Raphael-Tibbits/ClockV2/V2_1/ClockV2_1/ClockV2_1.csv

Reference | Qty | Value | DNP | Exclude from BOM | Exclude from Board | Footprint | Datasheet
BT1,BT2 | 2 | 2.4V 2s NiMH |  |  |  | Battery:BatteryHolder_Keystone_2468_2xAAA | ~
C1,C7,C11,C12,C13,C207 | 6 | 1u |  |  |  | Capacitor_SMD:C_0805_2012Metric | ~
C2 | 1 | 2.2u |  |  |  | Capacitor_SMD:C_0805_2012Metric | ~
C3,C201,C208 | 3 | 10n |  |  |  | Capacitor_SMD:C_0603_1608Metric | ~
C4 | 1 | 100n |  |  |  | Capacitor_SMD:C_0805_2012Metric | ~
C5,C6,C10 | 3 | 22u |  |  |  | Capacitor_SMD:C_1206_3216Metric | ~
C8 | 1 | 220n |  |  |  | Capacitor_SMD:C_0805_2012Metric | ~
C9 | 1 | 10u |  |  |  | Capacitor_SMD:C_1206_3216Metric | ~
C105 | 1 | 15p |  |  |  | Capacitor_SMD:C_0603_1608Metric | ~
C107,C109,C203 | 3 | 150p |  |  |  | Capacitor_SMD:C_0603_1608Metric | ~
C202 | 1 | 0.1-2p |  |  |  | Capacitor_SMD:C_Trimmer_Voltronics_JZ | ~
C204 | 1 | 3-30p |  |  |  | Capacitor_SMD:C_Trimmer_Voltronics_JZ | ~
C205 | 1 | 22p C0G |  |  |  | Capacitor_SMD:C_0805_2012Metric | ~
D1,D2,D4,D5 | 4 | B320 |  |  |  | Diode_SMD:D_SMC | http://www.jameco.com/Jameco/Products/ProdDS/1538777.pdf
D3 | 1 | 1.5SMCxxCA |  |  |  | Diode_SMD:D_SMC | https://www.vishay.com/docs/88303/15smc.pdf
D201 | 1 | 1N4148WS |  |  |  | Diode_SMD:D_SOD-323 | https://www.vishay.com/docs/85751/1n4148ws.pdf
D301,D302 | 2 | RED |  |  |  | LED_SMD:LED_0805_2012Metric | ~
D304 | 1 | GRN |  |  |  | LED_SMD:LED_0805_2012Metric | ~
DS401 | 1 | LTD-4608JR |  |  |  | LTD_4608JR:LTD-4608JR_LTO | LTD-4608JR
DS402 | 1 | TDCR1060M |  |  |  | TDCR1060M:DISPLAY_TDCR1060M
FB1 | 1 | FerriteBead |  |  |  | Inductor_SMD:L_1806_4516Metric | ~
H101,H102,H103,H104 | 4 | MountingHole_Pad |  |  |  | MountingHole:MountingHole_3.2mm_M3_DIN965_Pad | ~
J101 | 1 | Conn_Coaxial |  |  |  | Connector_Coaxial:SMA_Amphenol_132289_EdgeMount | ~
J103,J104,J201,J202 | 4 | Conn_02x04_Odd_Even |  |  |  | Connector_PinSocket_2.54mm:PinSocket_2x04_P2.54mm_Vertical | ~
J105 | 1 | DIN41612_02x16_AC_EvenPins |  |  |  | Connector_DIN:DIN41612_C_2x16_Male_Horizontal_THT | ~
J302 | 1 | Conn_02x04_Odd_Even |  |  |  | Connector_PinHeader_2.54mm:PinHeader_2x04_P2.54mm_Horizontal | ~
J303 | 1 | Conn_02x06_Odd_Even |  |  |  | Connector_PinHeader_2.54mm:PinHeader_2x06_P2.54mm_Horizontal | ~
j304 | 1 | Conn_01x04 |  |  |  | Connector_PinHeader_2.54mm:PinHeader_1x04_P2.54mm_Horizontal | ~
J401 | 1 | Conn_01x04 |  |  |  | Connector_PinHeader_2.54mm:PinHeader_1x04_P2.54mm_Vertical | ~
J402 | 1 | Conn_02x04_Odd_Even |  |  |  | Connector_PinHeader_2.54mm:PinHeader_2x04_P2.54mm_Vertical_SMD | ~
J403 | 1 | Conn_02x06_Odd_Even |  |  |  | Connector_PinHeader_2.54mm:PinHeader_2x06_P2.54mm_Vertical_SMD | ~
JP1,JP2,JP3,JP4,JP5,JP6,JP7,JP8,JP9 | 9 | SolderJumper_2_Open |  | Excluded from BOM |  | Jumper:SolderJumper-2_P1.3mm_Open_RoundedPad1.0x1.5mm | ~
L1 | 1 | 1.5u |  |  |  | Inductor_SMD:L_Bourns-SRU1028_10.0x10.0mm | ~
L101 | 1 | 8.4u 2% |  |  |  | Inductor_SMD:L_0603_1608Metric | ~
L102 | 1 | 620n 2% |  |  |  | Inductor_SMD:L_1008_2520Metric | ~
Q201 | 1 | IRLR024N |  |  |  | PCM_Package_TO_SOT_SMD_AKL:TO-252-2 | https://www.tme.eu/Document/adabf59c12041ebc2d466e35a3111f05/irlr024npbf.pdf
R1 | 1 | 22k |  |  |  | Resistor_SMD:R_0805_2012Metric | ~
R2 | 1 | 22R |  |  |  | Resistor_SMD:R_1206_3216Metric | ~
R3 | 1 | 107k |  |  |  | Resistor_SMD:R_0805_2012Metric | ~
R4 | 1 | 24.9k |  |  |  | Resistor_SMD:R_0805_2012Metric | ~
R5,R208 | 2 | 100k |  |  |  | Resistor_SMD:R_0805_2012Metric | ~
R107,R202,R203,R207,R311,R312 | 6 | 1k |  |  |  | Resistor_SMD:R_0805_2012Metric | ~
R111,R313,R314,R315 | 4 | 330R |  |  |  | Resistor_SMD:R_0805_2012Metric | ~
R201,R209,R210 | 3 | 47k |  |  |  | Resistor_SMD:R_0805_2012Metric | ~
R204 | 1 | 5M |  |  |  | Resistor_SMD:R_0805_2012Metric | ~
R205 | 1 | 470R |  |  |  | Resistor_SMD:R_0805_2012Metric | ~
R206 | 1 | 0.02R |  |  |  | Resistor_SMD:R_2512_6332Metric | ~
R301,R302,R303,R304,R305,R306,R307,R308,R310,R317,R318 | 11 | 150 |  |  |  | Resistor_SMD:R_0805_2012Metric | ~
R309 | 1 | LDR03 |  |  |  | OptoDevice:R_LDR_5.1x4.3mm_P3.4mm_Vertical | http://www.elektronica-componenten.nl/WebRoot/StoreNL/Shops/61422969/54F1/BA0C/C664/31B9/2173/C0A8/2AB9/2AEF/LDR03IMP.pdf
RV201 | 1 | 10k |  |  |  | Potentiometer_THT:Potentiometer_Bourns_3266W_Vertical | ~
SW301 | 1 | SW_Push |  |  |  | Button_Switch_THT:SW_PUSH_6mm_H4.3mm | ~
TH201 | 1 | Thermistor_NTC |  |  |  | Resistor_SMD:R_0805_2012Metric | ~
TP1,TP2 | 2 | TestPoint |  |  |  |  | ~
U1 | 1 | NUCLEO-L432KC |  | Excluded from BOM |  | ClockV2_1:MODULE_NUCLEO-L432KC
U2 | 1 | LMR33630CDDA |  |  |  | Package_SO:HTSOP-8-1EP_3.9x4.9mm_P1.27mm_EP2.4x3.2mm_ThermalVias | http://www.ti.com/lit/ds/symlink/lmr33630.pdf
U3 | 1 | LP2985-33DBVR |  |  |  | Package_TO_SOT_SMD:SOT-23-5 | http://www.ti.com/general/docs/suppproductinfo.tsp?distId=10
U201 | 1 | 74LVC1GX04 |  |  |  | Package_TO_SOT_SMD:SOT-23-6_Handsoldering
U202 | 1 | LMV358 |  |  |  | Package_SO:SOIC-8_3.9x4.9mm_P1.27mm | http://www.ti.com/lit/ds/symlink/lmv324.pdf
U301,U302,U303 | 3 | 74HC595 |  |  |  | Package_SO:SOIC-16_3.9x9.9mm_P1.27mm | http://www.ti.com/lit/ds/symlink/sn74hc595.pdf
Y201 | 1 | 16MHz |  |  |  | Crystal:Crystal_SMD_HC49-SD | ~
