Raphael-Tibbits/ClockV2/V2_1/ClockV2_1/ClockV2_1.step

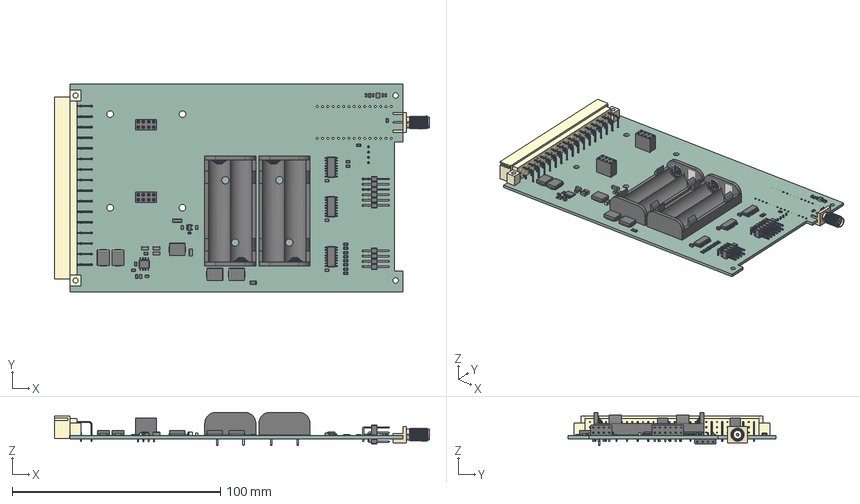
[picture p1: CAD file, 2026-08-30]
V2_1/ClockV2_1/ClockV2_1.step
180.2 x 100.0 x 16.0 mm
C_1206_3216Metric x 4
BatteryHolder_Keystone_2468_2xAAA x 2
R_0805_2012Metric x 16
D_SMC x 5
C_0805_2012Metric x 8
SOIC-16_3.9x9.9mm_P1.27mm x 3
PinSocket_2x04_P2.54mm_Vertical x 2
L_1806_4516Metric
HTSOP-8-1EP_3.9x4.9mm_P1.27mm_EP2.4x3.2mm
R_1206_3216Metric
L_0603_1608Metric
C_0603_1608Metric x 4
DIN41612_C_2x16_Male_Horizontal_THT
PinHeader_2x04_P2.54mm_Horizontal
L_1008_2520Metric
PinHeader_2x06_P2.54mm_Horizontal
SOT-23-5
SMA_Amphenol_132289_EdgeMount
PinHeader_1x04_P2.54mm_Horizontal
ClockV2_1_PCB
