Raphael-Tibbits/ClockV2/V2_1/Mechanical/ClockV2_osc.step

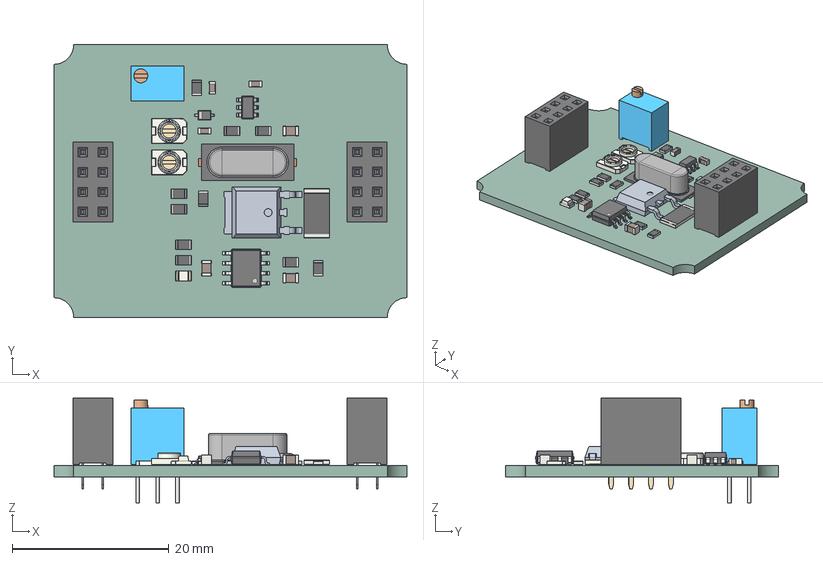
[picture p2: CAD file, 2026-08-30]
V2_1/Mechanical/ClockV2_osc.step
45.0 x 34.8 x 13.4 mm
R_0805_2012Metric x 10
Crystal_SMD_HC49-SD
ClockV2_osc 1.4.1
SOT-23-6
PinSocket_2x04_P2.54mm_Vertical x 2
C_0603_1608Metric x 3
C_Trimmer_Voltronics_JZ x 2
D_SOD-323
LED_0805_2012Metric
C_0805_2012Metric x 3
SOIC-8_3.9x4.9mm_P1.27mm
R_2512_6332Metric
Potentiometer_Bourns_3266W_Vertical
ClockV2_osc_PCB
