Raphael-Tibbits/ClockV2/V2_1/Mechanical/ClockV2_fp.step

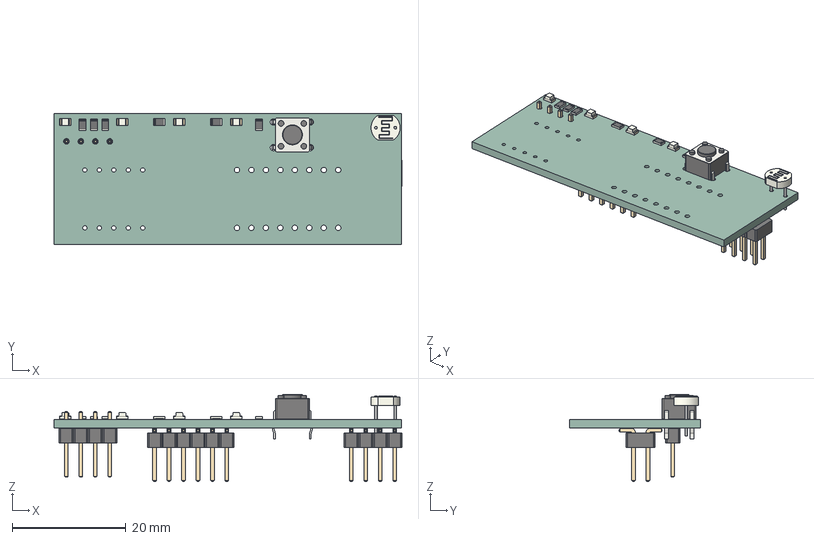
[picture p3: CAD file, 2026-08-30]
V2_1/Mechanical/ClockV2_fp.step
61.1 x 23.0 x 15.3 mm
LED_0805_2012Metric x 4
R_0805_2012Metric x 6
R_LDR_5.1x4.3mm_P3.4mm_Vertical
SW_PUSH_6mm_H4.3mm
PinHeader_2x06_P2.54mm_Vertical_SMD
PinHeader_2x04_P2.54mm_Vertical_SMD
PinHeader_1x04_P2.54mm_Vertical
ClockV2_fp_PCB
