Raphael-Tibbits/ClockV2/V2_1/Mechanical/ClockV2.step

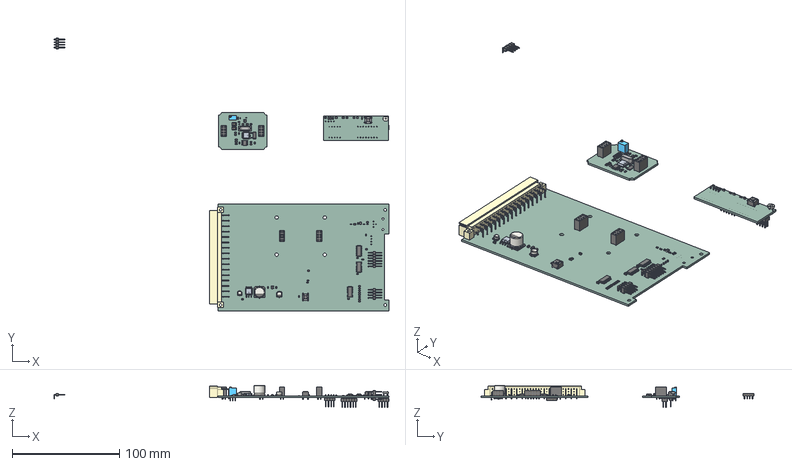
[picture p4: CAD file, 2026-08-30, an earlier design]
V2_1/Mechanical/ClockV2.step
313.0 x 254.9 x 21.0 mm
R_0805_2012Metric x 30
DIN41612_C_2x16_Male_Horizontal_THT
SW_PUSH_6mm_H4.3mm x 2
LED_0805_2012Metric x 5
Crystal_SMD_HC49-SD
ClockV2 1.8.1
C_0805_2012Metric x 11
PinHeader_2x04_P2.54mm_Horizontal
SOT-23-6
C_0603_1608Metric x 7
PinSocket_2x04_P2.54mm_Vertical x 4
L_1008_2520Metric
C_Trimmer_Voltronics_JZ x 2
SOIC-16_3.9x9.9mm_P1.27mm x 3
D_SOD-323
R_LDR_5.1x4.3mm_P3.4mm_Vertical
SOT-23-5
PinHeader_1x04_P2.54mm_Horizontal x 2
SOIC-8_3.9x4.9mm_P1.27mm
CP_Elec_5x3.9
CP_Elec_4x3
L_0603_1608Metric
ClockV2 1.68.1
R_2512_6332Metric
PinHeader_2x06_P2.54mm_Horizontal
CP_Elec_10x10
Potentiometer_Bourns_3266W_Vertical
PinHeader_2x06_P2.54mm_Vertical_SMD
PinHeader_2x04_P2.54mm_Vertical_SMD
PinHeader_1x04_P2.54mm_Vertical
ClockV2_PCB_1
ClockV2_PCB_2
ClockV2_PCB_3
