Raphael-Tibbits/ClockV2/(list of files, cad)

Other CAD files:
V2_1/Mechanical/ClockV2_1.step
V2_0/ClockV2.step
