Raphael-Tibbits/ClockV2/Manufacturing/Gerbers/Panel/Panel_Combined_Bottom.png

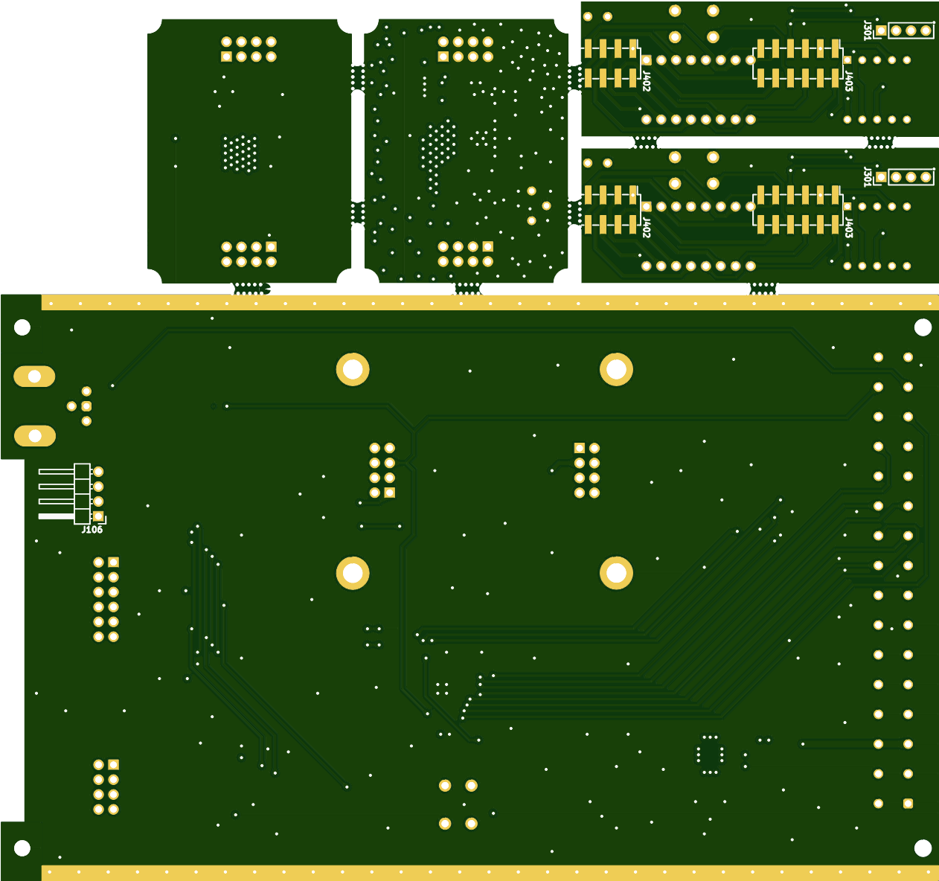
Manufacturing/Gerbers/Panel/Panel_Combined_Bottom.png
