Raphael-Tibbits/ClockV2/Manufacturing/Gerbers/Panel/Panel_Combined_Top.png

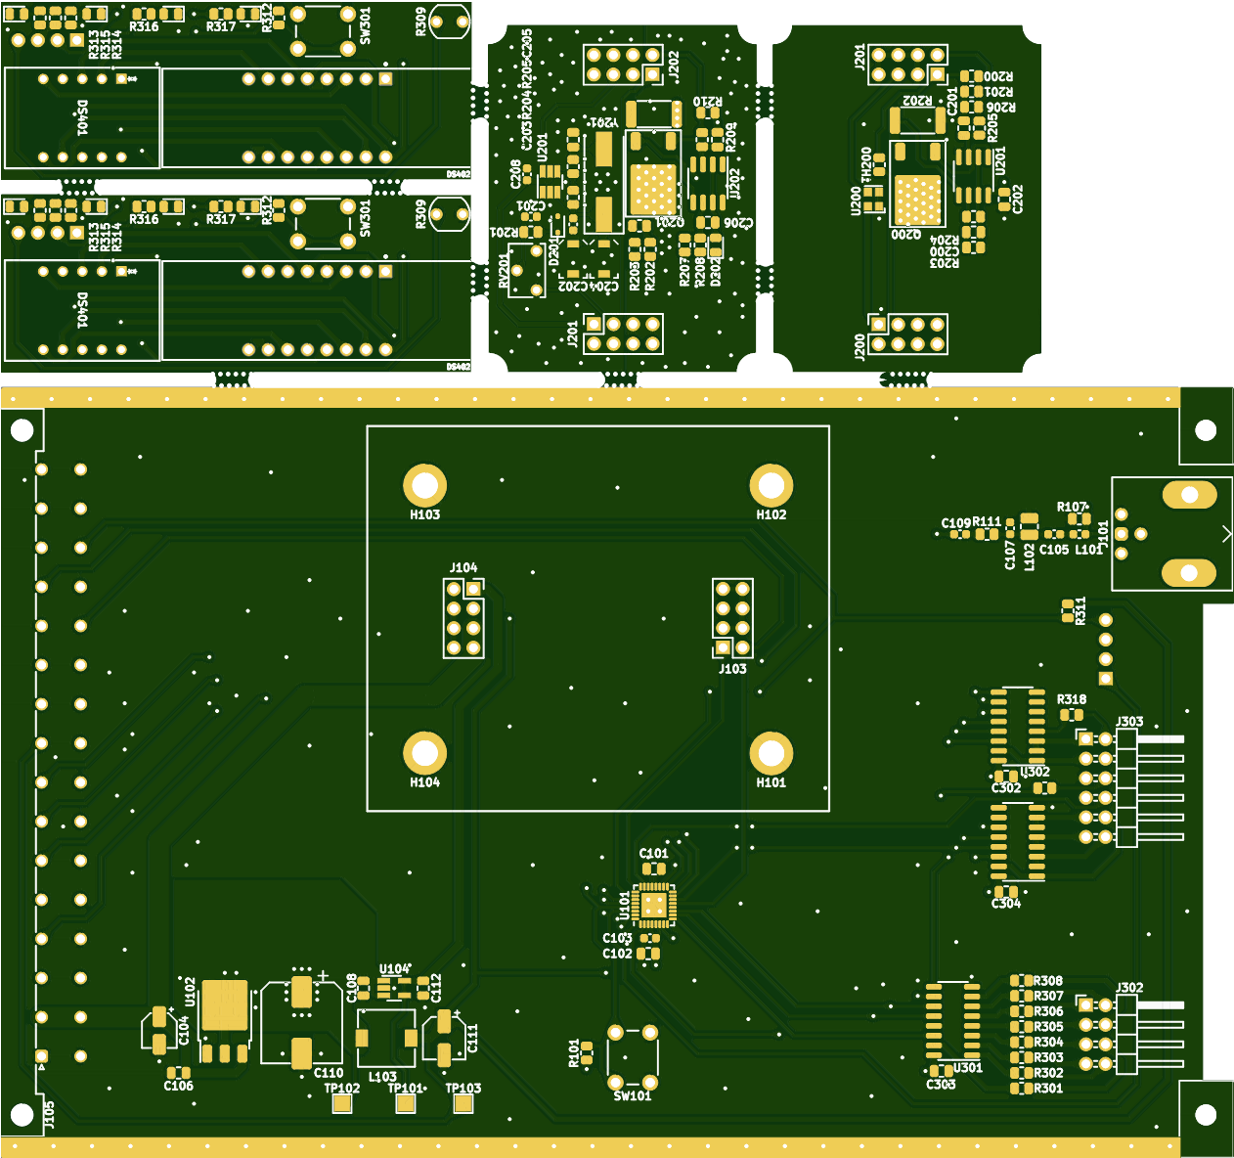
Manufacturing/Gerbers/Panel/Panel_Combined_Top.png
