Raphael-Tibbits/ClockV2/Sims/Draft5.asc

U1: UniversalOpAmp2
V1: voltage; 0.25; AC 0.25; Rser=0.2
V2: voltage; 3.3
Named nets: 0, 3.3V
