Raphael-Tibbits/ClockV2/Sims/AM Radio.asc

C1: cap; 220p
C2: cap; 10n
C3: cap; 220n
C4: cap; 220p
L1: ind; 100µ
L2: ind; 470n
L3: ind; 470µ
Q1: npn; 2N3904
Q2: npn; 2N3904
Q3: npn; 2N3904
Q4: npn; 2N3904
R1: res; 470
R2: res; 330k
R3: res; 27k
R4: res; 1m
R5: res; 10k
R6: res; 1k
R7: res; 10k
R8: res; 10k
R9: res; 220k
R10: res; 220k
R11: res; 50
R12: res; 50
V1: voltage; ""; AC 5m; Rser=0.5 Cpar=106p
V2: voltage; 9
V3: voltage; SINE(0 2 274k)
V4: voltage; SINE(0.65 9m 774k)
V5: voltage; ""; AC 1
Named nets: 0, 9V
.ac dec 1000 10k 10Meg
.tran 800u
