Raphael-Tibbits/ClockV2/Sims/Draft2.asc

D1: diode
D2: diode
D3: diode
D4: zener; BZX84C12L
M1: pmos
M2: pmos
M3: pmos
R1: res
R2: res
R3: res
R4: res
R5: res
R6: res
R7: res
S1: sw
V1: voltage
V2: voltage
V3: voltage
Named nets: 0
