Raphael-Tibbits/ClockV2/Sims/Draft3.asc

C1: cap; 4.7n
C2: cap; 100n
C3: cap; 4.7µ
C4: cap; 100µ
C5: cap; 10µ
D1: diode; 1N4148
D2: diode; 1N4148
Q1: npn; 2N3904
Q2: npn; 2N3904
Q3: pnp; 2SAR554P
Q4: npn; 2SCR554P
R1: res; 100k
R2: res; 1k
R3: res; 220k
R4: res; 220k
R5: res; 47k
R6: res; 47k
R7: res; {R_Vol}
R8: res; 1k
R11: res; 10k
R12: res; 10k
R13: res; 22
V1: voltage; 9
V2: voltage; SINE(4.5 20m 1k 50m); AC 1; Rser=1k
V4: voltage; 4.5
Named nets: 0, 9V
.ac dec 1000 1 100k
.op
.tran 100m
.step dec param R_Vol 10 1k 2
.include "C:\\Users\\raphg\\AppData\\Local\\LTspice\\lib\\sub\\BD135.mod"
.include "C:\\Users\\raphg\\AppData\\Local\\LTspice\\lib\\sub\\BD136.mod"
