Raphael-Tibbits/ClockV2/Sims/Heater.asc

C1: cap; 1µ
D1: LED; NSCW100
M1: nmos; irlru024n
R1: res; 0.02
R2: res; 47k
R3: res; 1k
U1: UniversalOpAmp2
U2: UniversalOpAmp2
V1: voltage; 5
V_in: voltage; ""
Named nets: 0, 5V
.tran 100
.inc C:\\Users\\raphg\\OneDrive\\Documents\\KiCad\\7.0\\projects\\ClockV2\\Sims\\irlru024n.spi
.dc V_in 0 3.3 0.05156
