Raphael-Tibbits/ClockV2/Sims/output filter.asc

C1: cap; {wc(150p, 0.01, 0)}
C2: cap; {wc(15p, 0.01, 2)}
C3: cap; 150p
L1: ind; {wc(620n, 0.02, 1)}
L2: ind; {wc(8.2µ, 0.05, 3)}
R1: res; 330; tol=0
R2: res; 1k
V1: voltage; PULSE(-0.8 0.8 0 2n 2n 3.125e-8 62.5n); AC 1
Named nets: 0
.ac dec 1k 10Meg 100Meg
.tran 10u
.func binary(run,index) floor(run/(2**index))-2*floor(run/(2**(index+1)))
.func wc(nom,tol,index) if(run==numruns,nom,if(binary(run,index),nom*(1+tol),nom*(1-tol)))
.step param run 0 16 1
.param numruns=16
