Raphael-Tibbits/ClockV2/(list of files, drawings)

Other design files:
Sims/LMR33630C_TRANS.DSN
Sims/LMR33630C_TRANS.opj
Sims/LMR33630CRNX_TRANS.OLB
