Raphael-Tibbits/ClockV2/V2_1/ClockV2_1/ClockV2_1.kicad_pcb

## KiCad design V2_1/ClockV2_1/ClockV2_1.kicad_pcb (2026-08-30)

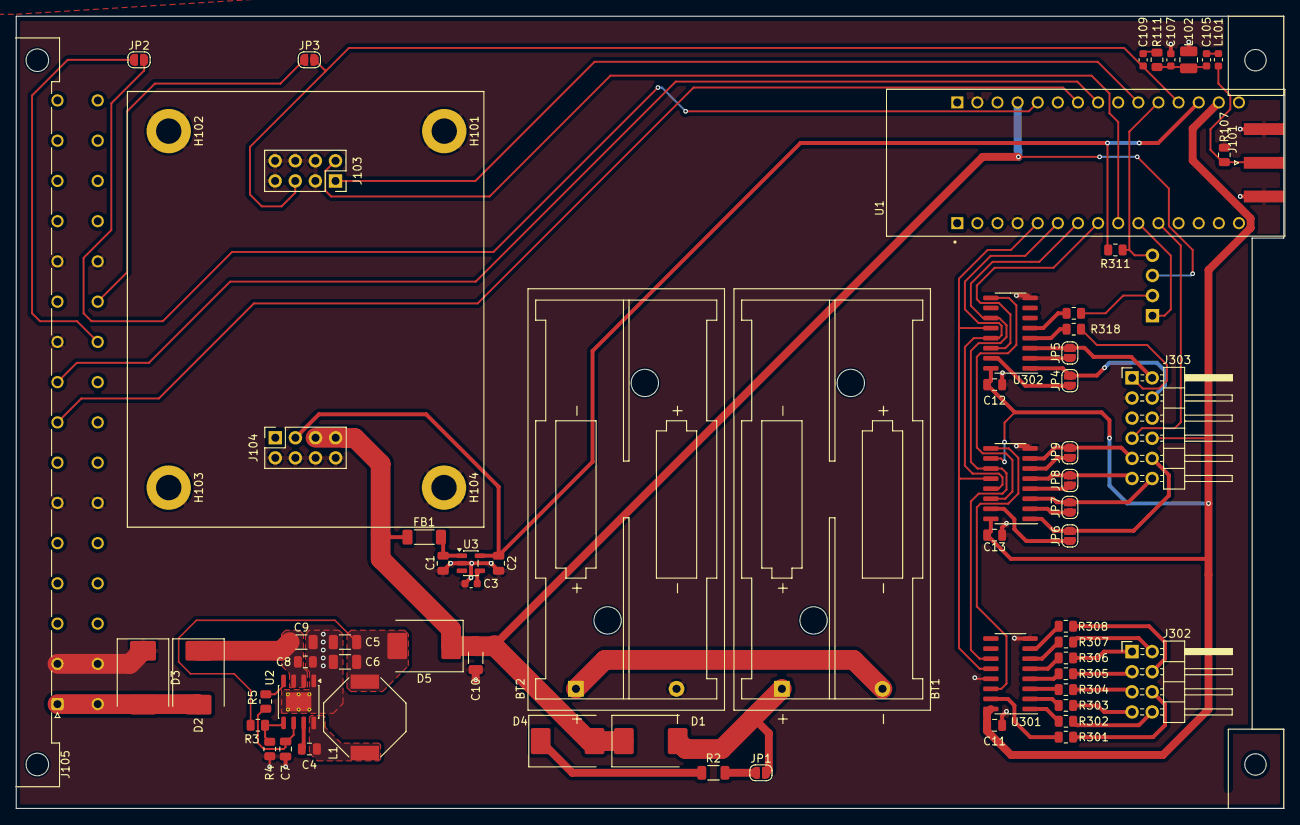
[picture p7: board ClockV2_1.kicad_pcb from above]

Board: 2 copper layers, 160.0 x 100.0 mm, 70 parts (1 on the bottom side), 71 nets.

Parts:
BT1, BT2: 2.4V 2s NiMH; BatteryHolder_Keystone_2468_2xAAA
C1, C7, C11, C12, C13: 1u; C_0805_2012Metric
C2: 2.2u; C_0805_2012Metric
C3: 10n; C_0603_1608Metric
C4: 100n; C_0805_2012Metric
C5, C6, C10: 22u; C_1206_3216Metric
C8: 220n; C_0805_2012Metric
C9: 10u; C_1206_3216Metric
C105: 15p; C_0603_1608Metric
C107, C109: 150p; C_0603_1608Metric
D1, D2, D4, D5: B320; D_SMC
D3: 1.5SMCxxCA; D_SMC
FB1: FerriteBead; L_1806_4516Metric
H101, H102, H103, H104: MountingHole_Pad; MountingHole_3.2mm_M3_DIN965_Pad
J101: Conn_Coaxial; SMA_Amphenol_132289_EdgeMount
J103, J104: Conn_02x04_Odd_Even; PinSocket_2x04_P2.54mm_Vertical
J105: DIN41612_02x16_AC_EvenPins; DIN41612_C_2x16_Male_Horizontal_THT
J302: Conn_02x04_Odd_Even; PinHeader_2x04_P2.54mm_Horizontal
J303: Conn_02x06_Odd_Even; PinHeader_2x06_P2.54mm_Horizontal
JP1, JP2, JP3, JP4, JP5, JP6, JP7, JP8, JP9: SolderJumper_2_Open; SolderJumper-2_P1.3mm_Open_RoundedPad1.0x1.5mm
L1: 1.5u; L_Bourns-SRU1028_10.0x10.0mm
L101: 8.4u 2%; L_0603_1608Metric
L102: 620n 2%; L_1008_2520Metric
R2: 22R; R_1206_3216Metric
R3: 107k; R_0805_2012Metric
R4: 24.9k; R_0805_2012Metric
R5: 100k; R_0805_2012Metric
R107, R311: 1k; R_0805_2012Metric
R111: 330R; R_0805_2012Metric
R301, R302, R303, R304, R305, R306, R307, R308, R310, R318: 150; R_0805_2012Metric
U1: NUCLEO-L432KC; MODULE_NUCLEO-L432KC
U2: LMR33630CDDA; HTSOP-8-1EP_3.9x4.9mm_P1.27mm_EP2.4x3.2mm_ThermalVias
U3: LP2985-33DBVR; SOT-23-5
U301, U302, U303: 74HC595; SOIC-16_3.9x9.9mm_P1.27mm
j304: Conn_01x04; PinHeader_1x04_P2.54mm_Horizontal

Connections:
+3.3V: C11.1, C12.1, C13.1, J303.8, U1.CN4_14 (+3V3), U301.10 (~SRCLR), U301.16 (VCC), U302.10 (~SRCLR), U302.16 (VCC), U303.10 (~SRCLR), U303.16 (VCC)
+3.3VA: C2.1, J104.3, R311.1, U1.CN4_13 (AREF), U3.5 (VOUT)
+5V: C10.1, D1.1 (K), D4.2 (A), D5.1 (K), FB1.1, J104.5, J104.7, U1.CN4_4 (+5V), j304.3
+12P: D2.2 (A), D3.2 (A2), J105.a2, J105.c2
+12V: C8.2, C9.1, D2.1 (K), U2.2 (VIN), U2.3 (EN)
/1Hz: JP2.2 (B), U1.CN4_5 (PA2)
/16MHz sine: J101.1 (In), L101.2, R107.1
/Display driver and io/A1: J303.4, JP4.2 (B), U302.1 (QB)
/Display driver and io/A2: J303.2, JP5.2 (B), U302.3 (QD)
/Display driver and io/A5: J303.9, JP9.2 (B), U303.7 (QH)
/Display driver and io/A6: J303.11, JP8.2 (B), U303.5 (QF)
/Display driver and io/A7: J303.12, JP7.2 (B), U303.3 (QD)
/Display driver and io/A8: J303.10, JP6.2 (B), U303.1 (QB)
/Display driver and io/LED2: J303.1, R318.2
/Display driver and io/LED3: R310.1, j304.2
/Display driver and io/a: J302.2, R307.2
/Display driver and io/b: J302.1, R306.2
/Display driver and io/c: J302.5, R304.2
/Display driver and io/d: J302.8, R302.2
/Display driver and io/dp: J302.7, R303.2
/Display driver and io/e: J302.6, R301.2
/Display driver and io/f: J302.4, R308.2
/Display driver and io/g: J302.3, R305.2
/Heater_PWM: J103.2, U1.CN3_9 (PB1)
/OE: U1.CN3_6 (PB0), U302.13 (~OE), U303.13 (~OE)
/Ock: U1.CN3_5 (PA12), U301.12 (RCLK), U302.12 (RCLK), U303.12 (RCLK)
/SDA: U1.CN3_8 (PB6), U302.14 (SER)
/Thermistor: J103.1, U1.CN4_10 (PA3)
/Xtal: C109.1, J103.5, JP3.2 (B), U1.CN4_12 (PA0)
/sck: U1.CN3_7 (PB7), U301.11 (SRCLK), U302.11 (SRCLK), U303.11 (SRCLK)
Button: J303.7, U1.CN3_11 (PC15)
GND: BT2.2 (-), C1.2, C2.2, C3.2, C5.2, C6.2, C7.2, C8.1, C9.2, C10.2, C11.2, C12.2, C13.2, C107.2, D3.1 (A1), H101.1, H102.1, H103.1, H104.1, J101.2 (Ext), J103.3, J103.4, J103.6, J103.7, J103.8, J104.2, J104.4, J104.6, J104.8, J105.a4, J105.a12, J105.a20, J105.a24, J105.c4, J105.c12, J105.c24, J303.3, J303.6, L102.2, R4.2, R107.2, U1.CN3_4 (GND_CN3), U1.CN4_2 (GND_CN4), U2.1 (GND), U2.9 (GND), U3.2 (GND), U301.8 (GND), U301.13 (~OE), U302.8 (GND), U303.8 (GND)
I2C SCL: J105.a16, U1.CN4_7 (PA6)
I2C SDA: J105.a18, U1.CN4_8 (PA5)
LED: U1.CN3_10 (PC14), j304.1
unnamed: BT1.1 (+), D1.2 (A), JP1.2 (B)
unnamed: BT1.2 (-), BT2.1 (+)
unnamed: C105.1, C107.1, L102.1, R111.2
unnamed: C105.2, L101.1
unnamed: C109.2, R111.1
unnamed: D4.1 (K), R2.1
unnamed: C5.1, C6.1, D5.2 (A), L1.2, R3.1
unnamed: J105.c20, JP2.1 (A)
unnamed: J105.c22, JP3.1 (A)
unnamed: JP1.1 (A), R2.2
unnamed: JP4.1 (A), U302.15 (QA)
unnamed: JP5.1 (A), U302.2 (QC)
unnamed: JP6.1 (A), U303.15 (QA)
unnamed: JP7.1 (A), U303.2 (QC)
unnamed: JP8.1 (A), U303.4 (QE)
unnamed: JP9.1 (A), U303.6 (QG)
unnamed: C4.1, U2.7 (BOOT)
unnamed: R3.2, R4.1, U2.5 (FB)
unnamed: R5.2, U2.4 (PG)
unnamed: C4.2, L1.1, U2.8 (SW)
unnamed: C7.1, R5.1, U2.6 (VCC)
unnamed: C3.1, U3.4 (BYP)
unnamed: C1.1, FB1.2, U3.1 (VIN), U3.3 (ON/~OFF)
unnamed: R301.1, U301.15 (QA)
unnamed: R302.1, U301.1 (QB)
unnamed: R303.1, U301.2 (QC)
unnamed: R304.1, U301.3 (QD)
unnamed: R305.1, U301.4 (QE)
unnamed: R306.1, U301.5 (QF)
unnamed: R307.1, U301.6 (QG)
unnamed: R308.1, U301.7 (QH)
unnamed: U301.14 (SER), U303.9 (QH')
unnamed: R318.1, U302.4 (QE)
unnamed: R310.2, U302.5 (QF)
unnamed: U302.9 (QH'), U303.14 (SER)
light_sense: R311.2, U1.CN4_11 (PA1), j304.4
