Raphael-Tibbits/ClockV2/Solaris pilot valve controller/Solaris pilot valve controller.kicad_pcb

## KiCad design Solaris pilot valve controller/Solaris pilot valve controller.kicad_pcb (2025-10-27)

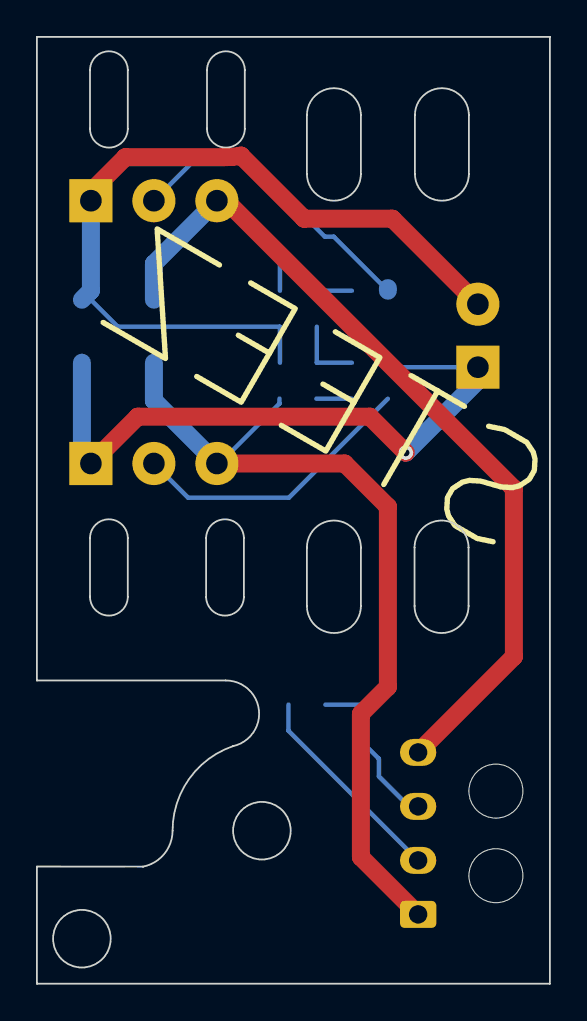
[picture p8: board Solaris pilot valve controller.kicad_pcb from above]

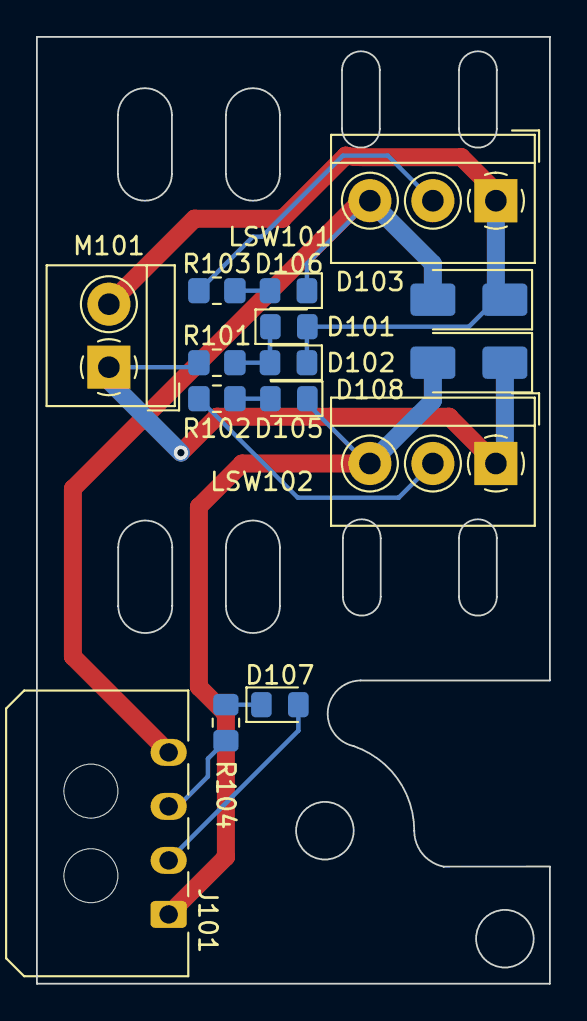
[picture p9: board Solaris pilot valve controller.kicad_pcb from below]

Board: 2 copper layers, 28.5 x 52.6 mm, 15 parts (15 on the bottom side), 12 nets.

Parts:
D101, D102, D105, D106, D107: LED; LED_0805_2012Metric_Pad1.15x1.40mm_HandSolder
D103, D108: M7; D_SMA
J101: 436500401; Molex_Micro-Fit_3.0_43650-0400_1x04_P3.00mm_Horizontal
LSW101, LSW102: SW_SPDT; TerminalBlock_4Ucon_1x03_P3.50mm_Horizontal
M101: Motor_DC_ALT; TerminalBlock_4Ucon_1x02_P3.50mm_Horizontal
R101, R102, R103, R104: 470R; R_0805_2012Metric_Pad1.20x1.40mm_HandSolder

Connections:
unnamed: D101.2 (A), D102.1 (K), D103.1 (K), LSW101.1 (COM), M101.2 (-)
unnamed: D101.1 (K), D102.2 (A), R101.1
unnamed: D103.2 (A), D106.1 (K), J101.4, LSW101.3 (NC)
unnamed: D105.2 (A), R102.1
unnamed: D105.1 (K), D108.2 (A), J101.1, LSW102.3 (NC)
unnamed: D106.2 (A), R103.1
unnamed: D107.2 (A), J101.2
unnamed: D107.1 (K), R104.2
unnamed: D108.1 (K), LSW102.1 (COM), M101.1 (+), R101.2
unnamed: J101.3, R104.1
unnamed: LSW101.2 (NO), R103.2
unnamed: LSW102.2 (NO), R102.2
