Raphael-Tibbits/ClockV2/TCXO_oscilator_module/TCXO_oscilator_module.kicad_pcb

## KiCad design TCXO_oscilator_module/TCXO_oscilator_module.kicad_pcb (2025-10-27)

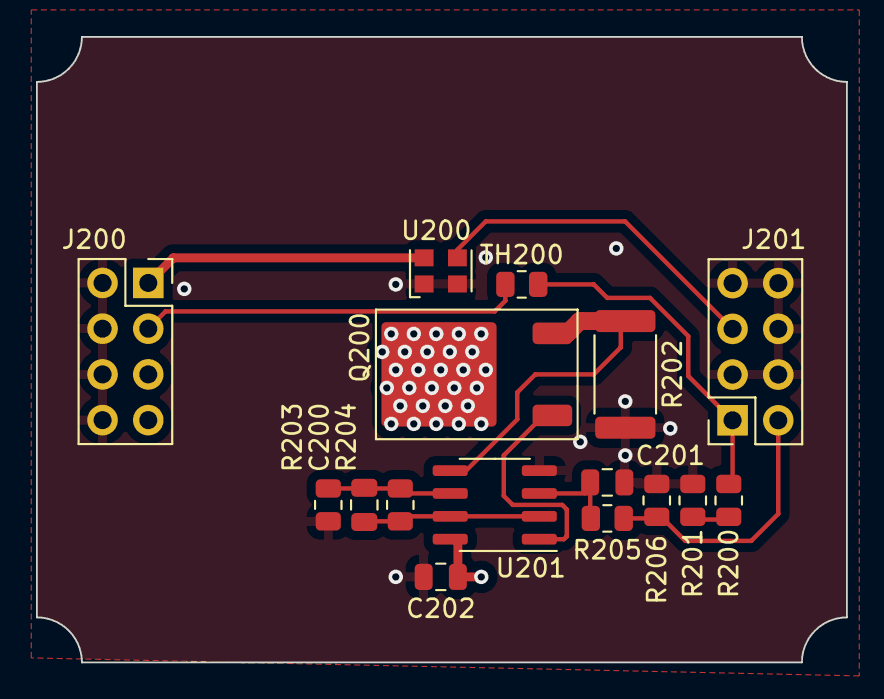
[picture p10: board TCXO_oscilator_module.kicad_pcb from above]

Board: 4 copper layers, 45.0 x 34.8 mm, 16 parts (0 on the bottom side), 13 nets.

Parts:
C200, C201, C202: 1u; C_0805_2012Metric
J200, J201: Conn_02x04_Odd_Even; PinSocket_2x04_P2.54mm_Vertical
Q200: IRLR024N; TO-252-2
R200, R201, R203: 1k; R_0805_2012Metric
R202: 0.02R; R_2512_6332Metric
R204, R205, R206: 47k; R_0805_2012Metric
TH200: Thermistor_NTC; R_0805_2012Metric
U200: KC2520Z; Oscillator_SMD_Kyocera_KC2520Z-4Pin_2.5x2.0mm
U201: LMV358; SOIC-8_3.9x4.9mm_P1.27mm

Connections:
+2V5: J200.1, U200.4 (VCC)
+3.3VA: J200.3, TH200.1
+5V: C202.1, J200.5, J200.7, Q200.2 (D), U201.8 (V+)
/Heater_PWM: J201.2, R205.2, R206.2
/Thermistor: J201.1, R200.1, TH200.2
/XTAL1: J201.5, U200.3 (CLK)
GND: C201.2, C202.2, J200.2, J200.4, J200.6, J200.8, J201.3, J201.4, J201.6, J201.7, J201.8, R201.2, R202.2, R203.2, R206.1, U200.1 (INH), U200.2 (GND), U201.4 (V-)
unnamed: Q200.1 (G), U201.1
unnamed: Q200.3 (S), R202.1, U201.5 (+)
unnamed: R200.2, R201.1
unnamed: C201.1, R205.1, U201.3 (+)
unnamed: C200.2, R204.2, U201.2 (-), U201.7
unnamed: C200.1, R203.1, R204.1, U201.6 (-)
