Raphael-Tibbits/ClockV2/V2_0/ClockV2_osc.kicad_pcb

## KiCad design V2_0/ClockV2_osc.kicad_pcb (2026-08-30, an earlier design)

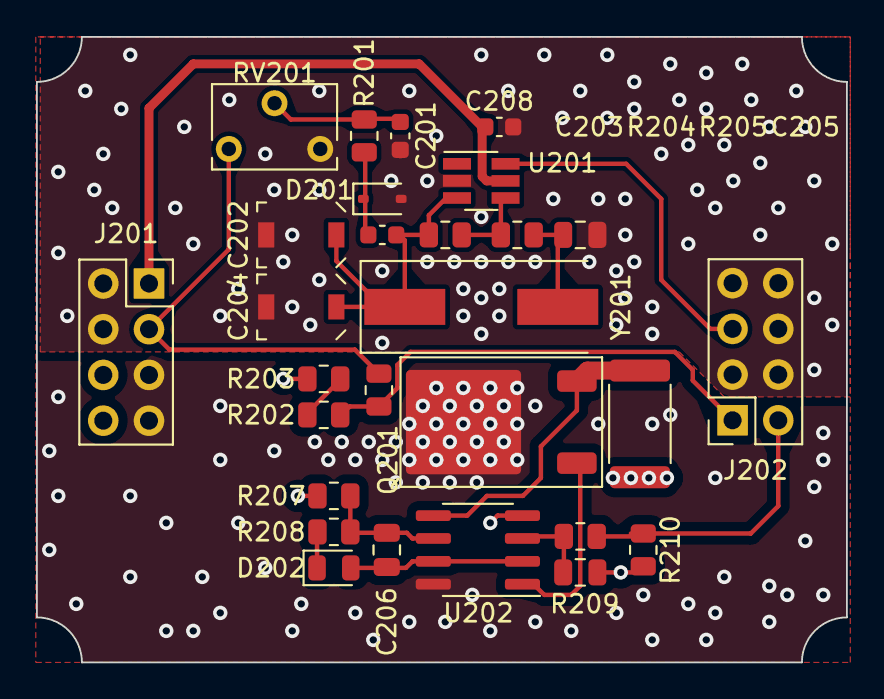
[picture p11: board ClockV2_osc.kicad_pcb from above]

Board: 4 copper layers, 45.0 x 34.8 mm, 28 parts (0 on the bottom side), 19 nets.

Parts:
C201, C208: 10n; C_0603_1608Metric
C202: 0.1-2p; C_Trimmer_Voltronics_JZ
C203: 150p; C_0603_1608Metric
C204: 3-30p; C_Trimmer_Voltronics_JZ
C205: 22p C0G; C_0805_2012Metric
C206, C207: 1u; C_0805_2012Metric
D201: 1N4148WS; D_SOD-323
D202: LED; LED_0805_2012Metric
J201, J202: Conn_02x04_Odd_Even; PinSocket_2x04_P2.54mm_Vertical
Q201: IRLR024N; TO-252-2
R201, R208, R209, R210: 47k; R_0805_2012Metric
R202, R203, R207: 1k; R_0805_2012Metric
R204: 5M; R_0805_2012Metric
R205: 470R; R_0805_2012Metric
R206: 0.02R; R_2512_6332Metric
RV201: 10k; Potentiometer_Bourns_3266W_Vertical
TH201: Thermistor_NTC; R_0805_2012Metric
U201: 74LVC1GX04; SOT-23-6_Handsoldering
U202: LMV358; SOIC-8_3.9x4.9mm_P1.27mm
Y201: 16MHz; Crystal_SMD_HC49-SD

Connections:
+2V5: C208.1, J201.1, U201.5 (VCC)
+3.3VA: J201.3, RV201.1, TH201.1
+5V: J201.5, J201.7, Q201.2 (D), U202.8 (V+)
/16MHz clk: J202.5, U201.6 (Y)
/Heat: J202.2, R209.2, R210.2
/Temp: J202.1, R202.1, TH201.2
GND: C201.2, C202.2, C204.2, C205.2, C207.2, C208.2, D201.2 (A), J201.2, J201.4, J201.6, J201.8, J202.3, J202.4, J202.6, J202.7, J202.8, R203.2, R206.2, R207.2, R210.1, RV201.3, U201.2 (GND), U202.4 (V-)
unnamed: C201.1, R201.1, RV201.2
unnamed: C205.1, R205.2, Y201.2
unnamed: C203.1, D201.1 (K), R201.2
unnamed: C206.2, D202.2 (A), U202.2 (-), U202.7
unnamed: D202.1 (K), R208.2
unnamed: Q201.1 (G), U202.1
unnamed: Q201.3 (S), R206.1, U202.5 (+)
unnamed: R202.2, R203.1
unnamed: C202.1, C203.2, C204.1, R204.2, U201.3 (X1), Y201.1
unnamed: R204.1, R205.1, U201.4 (X2)
unnamed: C207.1, R209.1, U202.3 (+)
unnamed: C206.1, R207.1, R208.1, U202.6 (-)
