Raphael-Tibbits/ClockV2/V2_0/ClockV2.kicad_pcb

## KiCad design V2_0/ClockV2.kicad_pcb (2026-08-30, an earlier design)

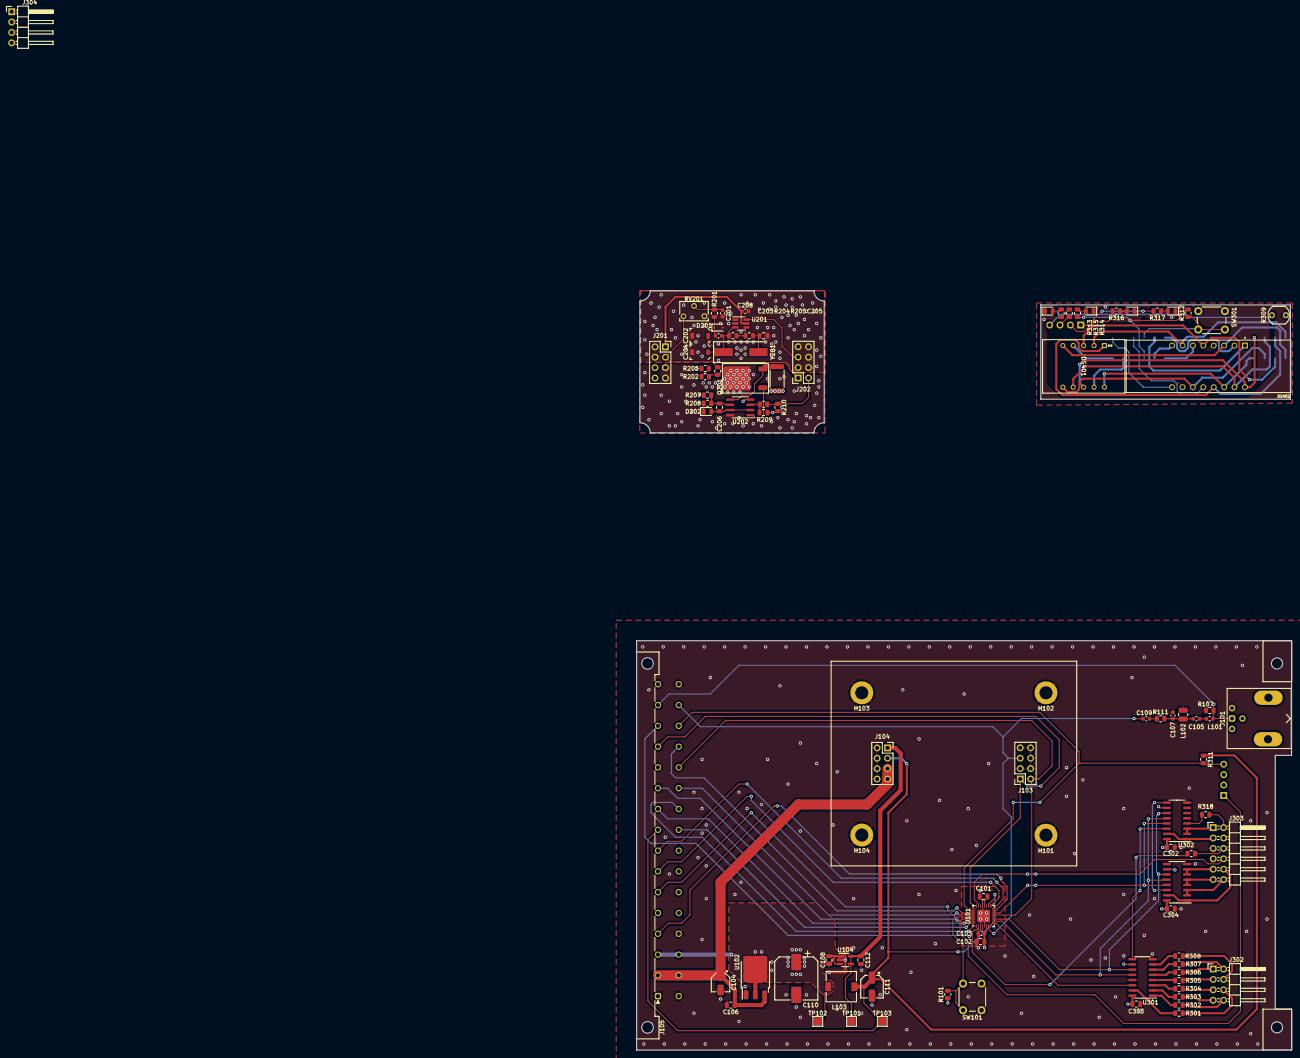
[picture p12: board ClockV2.kicad_pcb from above]

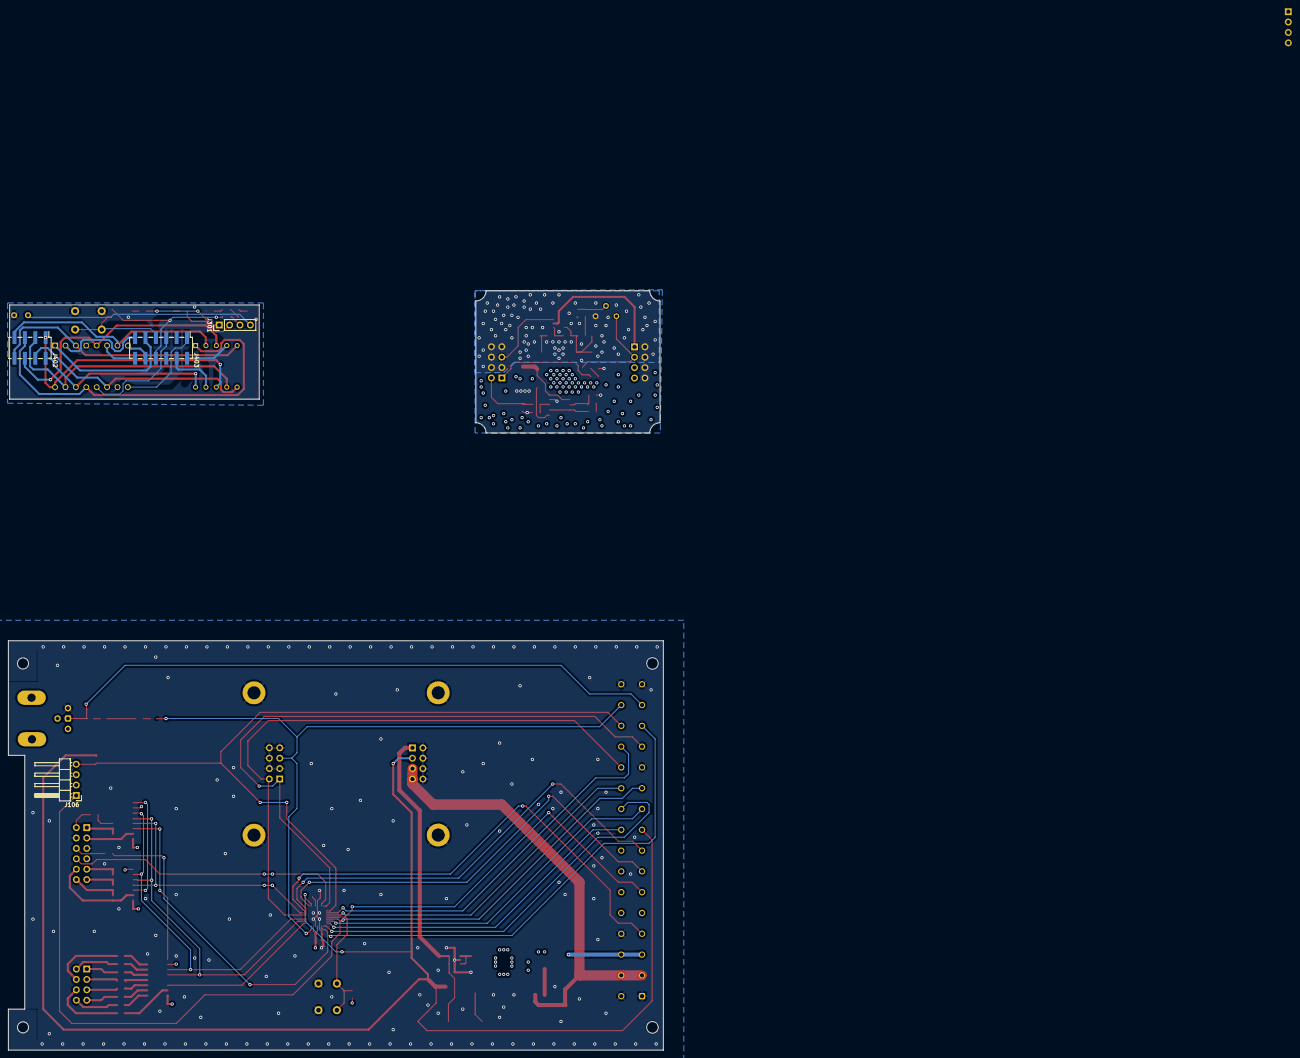
[picture p13: board ClockV2.kicad_pcb from below]

Board: 4 copper layers, 160.0 x 185.5 mm, 99 parts (4 on the bottom side), 74 nets.

Parts:
C101, C106, C108, C206, C207, C302, C303, C304: 1u; C_0805_2012Metric
C102: 100n; C_0805_2012Metric
C103, C201, C208: 10n; C_0603_1608Metric
C104: 4.7u; CP_Elec_4x3
C105: 15p; C_0603_1608Metric
C107, C109, C203: 150p; C_0603_1608Metric
C110: 220u; CP_Elec_10x10
C111: 47u; CP_Elec_5x3.9
C112: 2.2u; C_0805_2012Metric
C202: 0.1-2p; C_Trimmer_Voltronics_JZ
C204: 3-30p; C_Trimmer_Voltronics_JZ
C205: 22p C0G; C_0805_2012Metric
D201: 1N4148WS; D_SOD-323
D202: LED; LED_0805_2012Metric
D301, D302, D303: RED; LED_0805_2012Metric
D304: GRN; LED_0805_2012Metric
DS401: LTD-4608JR; LTD-4608JR_LTO
DS402: TDCR1060M; DISPLAY_TDCR1060M
H101, H102, H103, H104: MountingHole_Pad; MountingHole_3.2mm_M3_DIN965_Pad
J101: Conn_Coaxial; BNC_Amphenol_031-6575_Horizontal
J103, J104, J201, J202: Conn_02x04_Odd_Even; PinSocket_2x04_P2.54mm_Vertical
J105: DIN41612_02x16_AC_EvenPins; DIN41612_C_2x16_Male_Horizontal_THT
J106, J304: Conn_01x04; PinHeader_1x04_P2.54mm_Horizontal
J301: Conn_01x04; PinHeader_1x04_P2.54mm_Vertical
J302: Conn_02x04_Odd_Even; PinHeader_2x04_P2.54mm_Horizontal
J303: Conn_02x06_Odd_Even; PinHeader_2x06_P2.54mm_Horizontal
J402: Conn_02x04_Odd_Even; PinHeader_2x04_P2.54mm_Vertical_SMD
J403: Conn_02x06_Odd_Even; PinHeader_2x06_P2.54mm_Vertical_SMD
L101: 8.4u 2%; L_0603_1608Metric
L102: 620n 2%; L_1008_2520Metric
L103: 1m; L_7.3x7.3_H3.5
Q201: IRLR024N; TO-252-2
R101, R201, R208, R209, R210: 47k; R_0805_2012Metric
R107, R202, R203, R207, R311, R312: 1k; R_0805_2012Metric
R111, R313, R314, R315: 330R; R_0805_2012Metric
R204: 5M; R_0805_2012Metric
R205: 470R; R_0805_2012Metric
R206: 0.02R; R_2512_6332Metric
R301, R302, R303, R304, R305, R306, R307, R308, R310, R316, R317, R318: 150; R_0805_2012Metric
R309: LDR03; R_LDR_5.1x4.3mm_P3.4mm_Vertical
RV201: 10k; Potentiometer_Bourns_3266W_Vertical
SW101, SW301: SW_Push; SW_PUSH_6mm_H4.3mm
TH201: Thermistor_NTC; R_0805_2012Metric
TP101, TP102, TP103: TestPoint; TestPoint_Pad_2.0x2.0mm
U101: ATmega328P-M; QFN-32-1EP_5x5mm_P0.5mm_EP3.1x3.1mm
U102: LM1117DT-3.3; TO-252-3_TabPin2
U104: ADP7142ARDZ-2.5; SOT-23-5_HandSoldering
U201: 74LVC1GX04; SOT-23-6_Handsoldering
U202: LMV358; SOIC-8_3.9x4.9mm_P1.27mm
U301, U302, U303: 74HC595; SOIC-16_3.9x9.9mm_P1.27mm
Y201: 16MHz; Crystal_SMD_HC49-SD

Connections:
+2V5: C112.1, C208.1, J104.1, J106.2, J201.1, J301.2, J304.2, R316.2, TP101.1, U104.4 (SENSE/ADJ), U104.5 (VOUT), U201.5 (VCC)
+3.3V: C102.1, C103.1, C108.1, C110.1, C302.1, C303.1, C304.1, J105.a6, J105.c6, J303.7, J403.8, L103.1, R101.1, R312.1, R314.1, TP102.1, U101.4 (VCC), U101.6 (VCC), U102.2 (VO), U104.1 (VIN), U104.3 (EN), U301.10 (~SRCLR), U301.16 (VCC), U302.10 (~SRCLR), U302.16 (VCC), U303.10 (~SRCLR), U303.16 (VCC)
+3.3VA: C111.1, J104.3, J105.a18, J201.3, L103.2, R311.1, RV201.1, TH201.1, TP103.1, U101.18 (AVCC)
+5V: C104.1, C106.1, J104.5, J104.7, J105.a4, J105.c4, J106.3, J201.5, J201.7, J301.3, J304.3, Q201.2 (D), R315.1, U102.3 (VI), U202.8 (V+)
/1Hz: J105.a28, R310.2, U101.2 (PD4)
/7 seg Display/1PPS: DS402.12, J303.6, J403.5, R310.1
/7 seg Display/A1: DS401.9, J303.3, J403.4, U302.1 (QB), U302.15 (QA)
/7 seg Display/A2: DS401.4, J303.1, J403.2, U302.2 (QC), U302.3 (QD)
/7 seg Display/A5: DS402.1, J303.10, J403.9, U303.1 (QB), U303.15 (QA)
/7 seg Display/A6: DS402.2, J303.12, J403.11, U303.2 (QC), U303.3 (QD)
/7 seg Display/A7: DS402.6, J303.11, J403.12, U303.4 (QE), U303.5 (QF)
/7 seg Display/A8: DS402.8, J303.9, J403.10, U303.6 (QG), U303.7 (QH)
/7 seg Display/LED2: DS402.9, J303.2, J403.1, R318.2
/7 seg Display/ORClk: U101.10 (PD6), U301.12 (RCLK), U302.12 (RCLK), U303.12 (RCLK)
/7 seg Display/OutEn: U101.14 (PB2), U302.13 (~OE), U303.13 (~OE)
/7 seg Display/Sclk: U101.11 (PD7), U301.11 (SRCLK), U302.11 (SRCLK), U303.11 (SRCLK)
/7 seg Display/SerData: U101.9 (PD5), U301.14 (SER)
/7 seg Display/a: DS401.10, DS402.14, J302.2, J402.2, R307.2
/7 seg Display/b: DS401.8, DS402.16, J302.1, J402.1, R306.2
/7 seg Display/c: DS401.1, DS402.13, J302.5, J402.5, R304.2
/7 seg Display/d: DS401.5, DS402.3, J302.8, J402.8, R302.2
/7 seg Display/dp: DS401.2, DS402.7, J302.7, J402.7, R303.2
/7 seg Display/e: DS401.3, DS402.5, J302.6, J402.6, R301.2
/7 seg Display/f: DS401.6, DS402.11, J302.4, J402.4, R308.2
/7 seg Display/g: DS401.7, DS402.15, J302.3, J402.3, R305.2
/16MHz clk: C109.1, J103.5, J105.c30, J202.5, U101.7 (XTAL1/PB6), U201.6 (Y)
/16MHz sine: J101.1 (In), J105.a30, L101.2, R107.1
/AIO0: J105.c22, U101.28 (PC5)
/AIO1: J105.c26, U101.27 (PC4)
/DIO0: J105.a20, U101.31 (PD1)
/DIO1: J105.c18, U101.32 (PD2)
/DIO2: J105.c20, U101.1 (PD3)
/Heat: J103.2, J105.c24, J202.2, R209.2, R210.2, U101.13 (PB1)
/Temp: J103.1, J105.a26, J202.1, R202.1, TH201.2, U101.24 (PC1)
/miso: J105.a16, U101.16 (PB4)
/mosi: J105.a8, U101.15 (PB3)
/rst: J105.a12, R101.2, SW101.1, U101.29 (~RESET/PC6)
/sck: J105.a14, U101.17 (PB5)
Button: J303.8, J403.7, R312.2, SW301.1, U101.23 (PC0)
GND: C101.2, C102.2, C103.2, C104.2, C106.2, C107.2, C108.2, C110.2, C111.2, C112.2, C201.2, C202.2, C204.2, C205.2, C207.2, C208.2, C302.2, C303.2, C304.2, D201.2 (A), D301.1 (K), D302.1 (K), D303.1 (K), D304.1 (K), DS402.4, DS402.10, H101.1, H102.1, H103.1, H104.1, J101.2 (Ext), J103.3, J103.4, J103.6, J103.7, J103.8, J104.2, J104.4, J104.6, J104.8, J105.a2, J105.a24, J105.a32, J105.c2, J105.c8, J105.c32, J201.2, J201.4, J201.6, J201.8, J202.3, J202.4, J202.6, J202.7, J202.8, J303.4, J303.5, J403.3, J403.6, L102.2, R107.2, R203.2, R206.2, R207.2, R210.1, R309.2, RV201.3, SW101.2, SW301.2, U101.3 (GND), U101.5 (GND), U101.21 (GND), U101.33 (GND), U102.1 (GND), U104.2 (GND), U201.2 (GND), U202.4 (V-), U301.8 (GND), U301.13 (~OE), U302.8 (GND), U303.8 (GND)
LED: J105.a22, J106.1, J301.1, J304.1, R317.2, U101.30 (PD0)
unnamed: C105.1, C107.1, L102.1, R111.2
unnamed: C105.2, L101.1
unnamed: C109.2, R111.1
unnamed: C201.1, R201.1, RV201.2
unnamed: C205.1, R205.2, Y201.2
unnamed: C203.1, D201.1 (K), R201.2
unnamed: C206.2, D202.2 (A), U202.2 (-), U202.7
unnamed: D202.1 (K), R208.2
unnamed: D301.2 (A), R313.2
unnamed: D302.2 (A), R314.2
unnamed: D303.2 (A), R316.1
unnamed: D304.2 (A), R317.1
unnamed: Q201.1 (G), U202.1
unnamed: Q201.3 (S), R206.1, U202.5 (+)
unnamed: R202.2, R203.1
unnamed: R313.1, R315.2
unnamed: C101.1, U101.20 (AREF)
unnamed: C202.1, C203.2, C204.1, R204.2, U201.3 (X1), Y201.1
unnamed: R204.1, R205.1, U201.4 (X2)
unnamed: C207.1, R209.1, U202.3 (+)
unnamed: C206.1, R207.1, R208.1, U202.6 (-)
unnamed: R301.1, U301.15 (QA)
unnamed: R302.1, U301.1 (QB)
unnamed: R303.1, U301.2 (QC)
unnamed: R304.1, U301.3 (QD)
unnamed: R305.1, U301.4 (QE)
unnamed: R306.1, U301.5 (QF)
unnamed: R307.1, U301.6 (QG)
unnamed: U301.9 (QH'), U302.14 (SER)
unnamed: R308.1, U301.7 (QH)
unnamed: R318.1, U302.4 (QE)
unnamed: U302.9 (QH'), U303.14 (SER)
light_sense: J105.c28, J106.4, J301.4, J304.4, R309.1, R311.2, U101.26 (PC3)
