Raphael-Tibbits/ClockV2/V2_0/ClockV2_fp.kicad_pcb

## KiCad design V2_0/ClockV2_fp.kicad_pcb (2026-08-30, an earlier design)

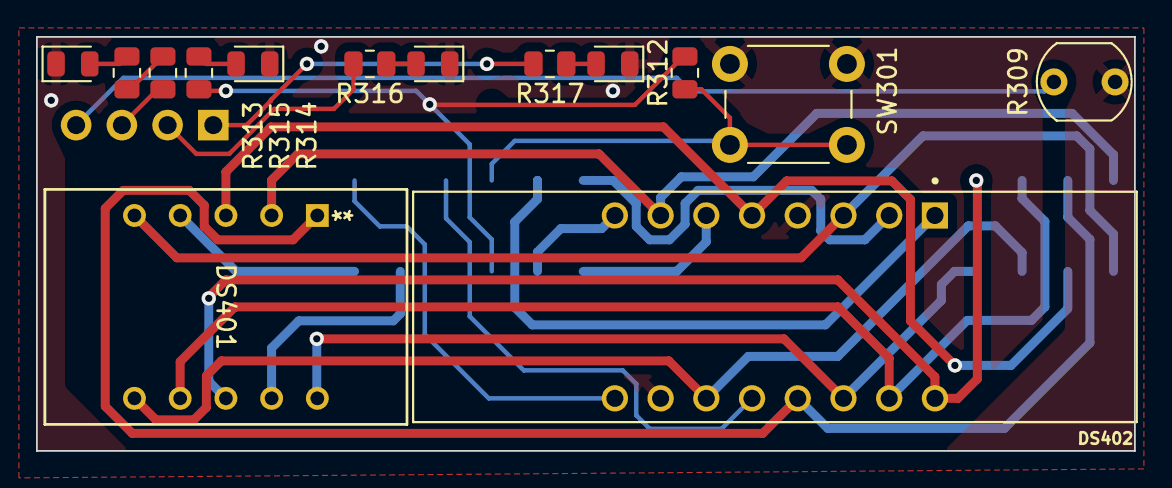
[picture p14: board ClockV2_fp.kicad_pcb from above]

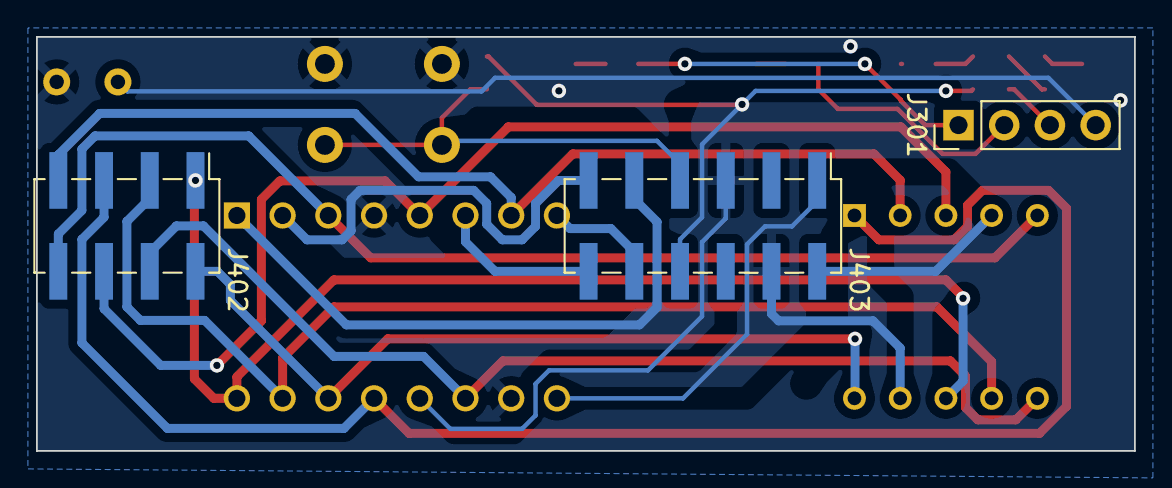
[picture p15: board ClockV2_fp.kicad_pcb from below]

Board: 4 copper layers, 61.0 x 23.0 mm, 17 parts (3 on the bottom side), 28 nets.

Parts:
D301, D302, D303: RED; LED_0805_2012Metric
D304: GRN; LED_0805_2012Metric
DS401: LTD-4608JR; LTD-4608JR_LTO
DS402: TDCR1060M; DISPLAY_TDCR1060M
J301: Conn_01x04; PinHeader_1x04_P2.54mm_Vertical
J402: Conn_02x04_Odd_Even; PinHeader_2x04_P2.54mm_Vertical_SMD
J403: Conn_02x06_Odd_Even; PinHeader_2x06_P2.54mm_Vertical_SMD
R309: LDR03; R_LDR_5.1x4.3mm_P3.4mm_Vertical
R312: 1k; R_0805_2012Metric
R313, R314, R315: 330R; R_0805_2012Metric
R316, R317: 150; R_0805_2012Metric
SW301: SW_Push; SW_PUSH_6mm_H4.3mm

Connections:
+2V5: J301.2, R316.2
+3.3V: J403.8, R312.1, R314.1
+5V: J301.3, R315.1
/7 seg Display/1PPS: DS402.12, J403.5
/7 seg Display/A1: DS401.9, J403.4
/7 seg Display/A2: DS401.4, J403.2
/7 seg Display/A5: DS402.1, J403.9
/7 seg Display/A6: DS402.2, J403.11
/7 seg Display/A7: DS402.6, J403.12
/7 seg Display/A8: DS402.8, J403.10
/7 seg Display/LED2: DS402.9, J403.1
/7 seg Display/a: DS401.10, DS402.14, J402.2
/7 seg Display/b: DS401.8, DS402.16, J402.1
/7 seg Display/c: DS401.1, DS402.13, J402.5
/7 seg Display/d: DS401.5, DS402.3, J402.8
/7 seg Display/dp: DS401.2, DS402.7, J402.7
/7 seg Display/e: DS401.3, DS402.5, J402.6
/7 seg Display/f: DS401.6, DS402.11, J402.4
/7 seg Display/g: DS401.7, DS402.15, J402.3
Button: J403.7, R312.2, SW301.1
GND: D301.1 (K), D302.1 (K), D303.1 (K), D304.1 (K), DS402.4, DS402.10, J403.3, J403.6, R309.2, SW301.2
LED: J301.1, R317.2
unnamed: D301.2 (A), R313.2
unnamed: D302.2 (A), R314.2
unnamed: D303.2 (A), R316.1
unnamed: D304.2 (A), R317.1
unnamed: R313.1, R315.2
light_sense: J301.4, R309.1
