Raphael-Tibbits/ClockV2/Software/CLK_V2_1_STM/Core/Src/main.cpp

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
/* Includes ------------------------------------------------------------------*/
#include "main.h"
#include "cmsis_os.h"

/* USER CODE BEGIN Includes */
#include <stdio.h>

#include "controller.hpp"

/* USER CODE END Includes */

typedef StaticTask_t osStaticThreadDef_t;
ADC_HandleTypeDef hadc1;

I2C_HandleTypeDef hi2c1;

RTC_HandleTypeDef hrtc;

SPI_HandleTypeDef hspi3;

TIM_HandleTypeDef htim1;

UART_HandleTypeDef huart2;

/* Definitions for uartTask */
osThreadId_t uartTaskHandle;
const osThreadAttr_t uartTask_attributes = {
  .name = "uartTask",
  .stack_size = 128 * 4,
  .priority = (osPriority_t) osPriorityLow,
};
/* Definitions for BlinyBill */
osThreadId_t BlinyBillHandle;
uint32_t BlinyBillBuffer[ 256 ];
osStaticThreadDef_t BlinyBillControlBlock;
const osThreadAttr_t BlinyBill_attributes = {
  .name = "BlinyBill",
  .cb_mem = &BlinyBillControlBlock,
  .cb_size = sizeof(BlinyBillControlBlock),
  .stack_mem = &BlinyBillBuffer[0],
  .stack_size = sizeof(BlinyBillBuffer),
  .priority = (osPriority_t) osPriorityLow1,
};
/* Definitions for DisplayMultiple */
osThreadId_t DisplayMultipleHandle;
uint32_t DisplayMultipleBuffer[ 256 ];
osStaticThreadDef_t DisplayMultipleControlBlock;
const osThreadAttr_t DisplayMultiple_attributes = {
  .name = "DisplayMultiple",
  .cb_mem = &DisplayMultipleControlBlock,
  .cb_size = sizeof(DisplayMultipleControlBlock),
  .stack_mem = &DisplayMultipleBuffer[0],
  .stack_size = sizeof(DisplayMultipleBuffer),
  .priority = (osPriority_t) osPriorityNormal7,
};
/* Definitions for HeaterControl */
osThreadId_t HeaterControlHandle;
uint32_t HeaterControlBuffer[ 256 ];
osStaticThreadDef_t HeaterControlControlBlock;
const osThreadAttr_t HeaterControl_attributes = {
  .name = "HeaterControl",
  .cb_mem = &HeaterControlControlBlock,
  .cb_size = sizeof(HeaterControlControlBlock),
  .stack_mem = &HeaterControlBuffer[0],
  .stack_size = sizeof(HeaterControlBuffer),
  .priority = (osPriority_t) osPriorityAboveNormal,
};
/* USER CODE BEGIN PV */

RTC_TimeTypeDef now;
RTC_DateTypeDef today;

Heater_controller Oven(0.0f, 0.0f, 40.0f);
/* USER CODE END PV */

void SystemClock_Config(void);
static void MX_GPIO_Init(void);
static void MX_ADC1_Init(void);
static void MX_I2C1_Init(void);
static void MX_RTC_Init(void);
static void MX_TIM1_Init(void);
static void MX_USART2_UART_Init(void);
static void MX_SPI3_Init(void);
void StartIdleTask(void *argument);
void StartBlinkTask(void *argument);
void StartDisplay(void *argument);
void StartHeater(void *argument);

/**
  * @brief  The application entry point.
  * @retval int
  */
int main(void)
{

  /* MCU Configuration--------------------------------------------------------*/

  /* Reset of all peripherals, Initializes the Flash interface and the Systick. */
  HAL_Init();

  /* Configure the system clock */
  SystemClock_Config();

  /* Initialize all configured peripherals */
  MX_GPIO_Init();
  MX_ADC1_Init();
  MX_I2C1_Init();
  MX_RTC_Init();
  MX_TIM1_Init();
  MX_USART2_UART_Init();
  MX_SPI3_Init();
  /* Init scheduler */
  osKernelInitialize();

  /* USER CODE BEGIN RTOS_MUTEX */
	/* add mutexes, ... */
  /* USER CODE END RTOS_MUTEX */

  /* USER CODE BEGIN RTOS_SEMAPHORES */
	/* add semaphores, ... */
  /* USER CODE END RTOS_SEMAPHORES */

  /* USER CODE BEGIN RTOS_TIMERS */
	/* start timers, add new ones, ... */
  /* USER CODE END RTOS_TIMERS */

  /* USER CODE BEGIN RTOS_QUEUES */
	/* add queues, ... */
  /* USER CODE END RTOS_QUEUES */

  /* Create the thread(s) */
  /* creation of uartTask */
  uartTaskHandle = osThreadNew(StartIdleTask, NULL, &uartTask_attributes);

  /* creation of BlinyBill */
  BlinyBillHandle = osThreadNew(StartBlinkTask, NULL, &BlinyBill_attributes);

  /* creation of DisplayMultiple */
  DisplayMultipleHandle = osThreadNew(StartDisplay, NULL, &DisplayMultiple_attributes);

  /* creation of HeaterControl */
  HeaterControlHandle = osThreadNew(StartHeater, NULL, &HeaterControl_attributes);

  /* USER CODE BEGIN RTOS_THREADS */
	/* add threads, ... */
  /* USER CODE END RTOS_THREADS */

  /* USER CODE BEGIN RTOS_EVENTS */
	/* add events, ... */

  /* USER CODE END RTOS_EVENTS */

  /* Start scheduler */
  osKernelStart();

  /* We should never get here as control is now taken by the scheduler */

  /* Infinite loop */
  /* USER CODE BEGIN WHILE */
	while (1)
	{
    /* USER CODE END WHILE */

    /* USER CODE BEGIN 3 */
	}
  /* USER CODE END 3 */
}

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
/* USER CODE BEGIN Header_StartIdleTask */
/**
 * @brief  Function implementing the IdleTask thread.
 * @param  argument: Not used
 * @retval None
 */
/* USER CODE END Header_StartIdleTask */
void StartIdleTask(void *argument)
{
//  /* USER CODE BEGIN 5 */
	uint8_t message_buffer[63] = "Hello World\n\r";
//
	HAL_UART_Transmit(&huart2, message_buffer , 14, HAL_MAX_DELAY);

	/* Infinite loop */
	for(;;)
	{
//		HAL_RTC_GetTime(&hrtc, &now, RTC_FORMAT_BIN);
//		HAL_RTC_GetDate(&hrtc, &today, RTC_FORMAT_BIN);
//
//
//		sprintf((char*)message_buffer, "the time: %02u:%02u:%02u.%04lu\toven Temp: %2.2f\r", now.Hours, now.Minutes, now.Seconds, now.SubSeconds, Oven.get_temp());
////		HAL_UART_Transmit(&huart2, message_buffer , sizeof(message_buffer), HAL_MAX_DELAY);
		osDelay(50);
	}
  /* USER CODE END 5 */
}

/* USER CODE BEGIN Header_StartBlinkTask */
/**
 * @brief Function implementing the BlinyBill thread.
 * @param argument: Not used
 * @retval None
 */
/* USER CODE END Header_StartBlinkTask */
void StartBlinkTask(void *argument)
{
  /* USER CODE BEGIN StartBlinkTask */
	/* Infinite loop */
	for(;;)
	{
		HAL_GPIO_TogglePin(GPIOA, GPIO_PIN_12);

		osDelay(500);
	}
  /* USER CODE END StartBlinkTask */
}

/* USER CODE BEGIN Header_StartDisplay */
/**
 * @brief Function implementing the DisplayMultiple thread.
 * @param argument: Not used
 * @retval None
 */
#define DISP_LED2_MSK 0x10
#define DISP_DP_MSK 0x02
#define DISP_Digit1 0x0C
#define DISP_Digit2 0x03
#define DISP_Digit3 ((uint8_t)(~0xC0))
#define DISP_Digit4 ((uint8_t)(~0x30))
#define DISP_Digit5 ((uint8_t)(~0x0C))
#define DISP_Digit6 ((uint8_t)(~0x03))



const uint8_t int_2_segment[] = {
		0x7D, /* 0 = 0b01111101 -> segments a b c d e f (g off, dp off) */
		0x41, /* 1 = 0b01000001 -> segments b c */
		0xEC, /* 2 = 0b11101100 -> segments a b g e d */
		0xE5, /* 3 = 0b11100101 -> segments a b c d g */
		0xD1, /* 4 = 0b11010001 -> segments f g b c */
		0xB5, /* 5 = 0b10110101 -> segments a f g c d */
		0xBD, /* 6 = 0b10111101 -> segments a f e d c g */
		0x61, /* 7 = 0b01100001 -> segments a b c  (note: binary shows bit7..0) */
		0xFD, /* 8 = 0b11111101 -> all segments on (dp off) */
		0xF5, /* 9 = 0b11110101 -> segments a b c d f g */

		0xF9, /* A = 0b11111001 -> a b c e f g (no d) */
		0x9D, /* b = 0b10011101 -> lowercase b (f e d c g) */
		0x3C, /* C = 0b00111100 -> a f e d */
		0xCD, /* d = 0b11001101 -> lowercase d (b c d e g) */
		0xBC, /* E = 0b10111100 -> a f e d g */
		0xB8  /* F = 0b10111000 -> a f e g */
};



void send_to_disp(uint8_t* sft_buf){

	HAL_SPI_Transmit(&hspi3, sft_buf, 3, HAL_MAX_DELAY);
	HAL_GPIO_WritePin(DISP_ORCLK_GPIO_Port, DISP_ORCLK_Pin, GPIO_PIN_SET);
	__NOP();
	HAL_GPIO_WritePin(DISP_ORCLK_GPIO_Port, DISP_ORCLK_Pin, GPIO_PIN_RESET);

	return;

}

/* USER CODE END Header_StartDisplay */
void StartDisplay(void *argument)
{
  /* USER CODE BEGIN StartDisplay */

	//	HAL_TIM_PWM_Start(&htim1, TIM_CHANNEL_3);
	//	HAL_TIMEx_PWMN_Start(&htim1, TIM_CHANNEL_3);
	//
	//	__HAL_TIM_SET_COMPARE(&htim1, TIM_CHANNEL_3, 6399);
	HAL_GPIO_WritePin(GPIOA, GPIO_PIN_11, GPIO_PIN_RESET);

	/* Infinite loop */
	uint8_t num = 0;
	uint8_t shift_buffer[3];
	for(;;)
	{
		for(int i = 0; i<100; i++){

			shift_buffer[1] = DISP_Digit1;
			shift_buffer[2] = 0xFF^int_2_segment[(num)%10];

//			send_to_disp(shift_buffer);

			osDelay(1);

			shift_buffer[1] = DISP_Digit2;
			shift_buffer[2] = 0xFF^int_2_segment[(num/10)%10];

//			send_to_disp(shift_buffer);

			osDelay(1);
		}
		num ++;
	}
  /* USER CODE END StartDisplay */
}

/* USER CODE BEGIN Header_StartHeater */
/**
 * @brief Function implementing the HeaterControl thread.
 * @param argument: Not used
 * @retval None
 */
/* USER CODE END Header_StartHeater */
void StartHeater(void *argument)
{
  /* USER CODE BEGIN StartHeater */
//
//	HAL_TIM_PWM_Start(&htim1, TIM_CHANNEL_4);
//	__HAL_TIM_SET_COMPARE(&htim1, TIM_CHANNEL_4, 0);
//

	/* Infinite loop */
	for(;;)
	{
//		Oven.update();
//		osDelay(40);
	}
  /* USER CODE END StartHeater */
}

/**
  * @brief  Period elapsed callback in non blocking mode
  * @note   This function is called  when TIM2 interrupt took place, inside
  * HAL_TIM_IRQHandler(). It makes a direct call to HAL_IncTick() to increment
  * a global variable "uwTick" used as application time base.
  * @param  htim : TIM handle
  * @retval None
  */
void HAL_TIM_PeriodElapsedCallback(TIM_HandleTypeDef *htim)
{
  if (htim->Instance == TIM2)
  {
    HAL_IncTick();
  }
}

/**
  * @brief  This function is executed in case of error occurrence.
  * @retval None
  */
void Error_Handler(void)
{
  /* USER CODE BEGIN Error_Handler_Debug */
	/* User can add his own implementation to report the HAL error return state */
	__disable_irq();
	while (1)
	{
	}
  /* USER CODE END Error_Handler_Debug */
}

#ifdef  USE_FULL_ASSERT
/**
  * @brief  Reports the name of the source file and the source line number
  *         where the assert_param error has occurred.
  * @param  file: pointer to the source file name
  * @param  line: assert_param error line source number
  * @retval None
  */
void assert_failed(uint8_t *file, uint32_t line)
{
  /* USER CODE BEGIN 6 */
	/* User can add his own implementation to report the file name and line number,
     ex: printf("Wrong parameters value: file %s on line %d\r\n", file, line) */
  /* USER CODE END 6 */
}
#endif /* USE_FULL_ASSERT */
