Raphael-Tibbits/ClockV2/Software/CLK_V2_1_STM/Clk_V2_1_STM.ioc

Mcu.UserName=STM32L432KCUx
PA0.Signal=RCC_CK_IN
PA1.GPIO_Label=Light_sensor
PA1.Signal=ADCx_IN6
PA10.Signal=I2C1_SDA
PA11.GPIO_Label=DISP_OE
PA11.Signal=S_TIM1_CH4
PA12.GPIO_Label=LED_Front
PA12.Signal=GPIO_Output
PA2.Signal=USART2_TX
PA3.GPIO_Label=Temp_sensor
PA3.Signal=ADCx_IN8
PA9.Signal=I2C1_SCL
PB1.GPIO_Label=Heater
PB1.Signal=TIM1_CH3N
PB5.GPIO_Label=DISP_SDAT
PB5.Signal=SPI3_MOSI
