Raphael-Tibbits/ClockV2/(commit log)

2025-11-09 more STM
    added display for the working digits, started adding heater control and added timekeeping with RTC
2025-11-29 New Kicad Project for V2.1
    moved the V2 to a new folder and made V2.1 folder for STM32 version
2025-12-04 schematics continued
    added power supplies and main sheet
