Raphael-Tibbits/ClockV2/(notices)

Notices in the files:
Software/CLK_V2_1_STM/Core/Src/main.cpp:
Copyright (c) 2025 STMicroelectronics.
All rights reserved.
This software is licensed under terms that can be found in the LICENSE file
